peterbalch/MIDI-Theremin/(list of files, drawings)

Other design files:
MidiTheremin.pcb
